loonaarc/conf/docs/evidence.md

# Project Evidence

Paste screenshots and photos directly below each heading.

Tip: after pasting an image, keep the short caption below it. The captions can be reused in the final report.

## 1. Monitoring Node Wiring

Monitoring node current wiring

Figure 1 shows the earlier ESP #1 monitoring-node wiring with PIR, reed switch, DS18B20 temperature sensor, and shared 3.3V/GND breadboard rails. The final architecture moves DS18B20 temperature to the ESP #3 context node; capture updated wiring evidence after the move.

## 2. Monitoring Node Tasmota Module Configuration

Monitoring node current Tasmota module configuration
Figure 2 shows the Tasmota GPIO configuration for ESP #1:

```text
D2 / GPIO4  -> Switch1, PIR motion sensor
D4 / GPIO2  -> DS18x20 temperature sensor in the earlier setup
D6 / GPIO12 -> Switch2, reed switch
```

## 3. Tasmota Console: PIR And Reed Events

Tasmota console with PIR and reed events

Figure 3 shows the Tasmota console publishing `Switch1` events from the PIR sensor and `Switch2` events from the reed switch.

## 4. MQTT Explorer: Switch Events

MQTT Explorer switch result topic

Figure 4 shows MQTT Explorer receiving switch events from the monitoring node under:

```text
stat/safety_monitor_1/RESULT
```

This proves that the sensor node publishes PIR and reed events to the MQTT broker.

## 5. MQTT Explorer: Temperature Sensor

MQTT Explorer temperature sensor telemetry

Figure 5 shows MQTT Explorer receiving DS18B20 temperature telemetry in the earlier setup under:

```text
tele/safety_monitor_1/SENSOR
```

This proves that the monitoring node also publishes periodic sensor telemetry.

## 6. Alarm Node Wiring

Alarm node wiring

Figure 6 shows ESP #2, the alarm node, connected to the relay and PWM buzzer actuator.

## 7. Alarm Node Tasmota Module Configuration

Alarm node Tasmota module configuration

Figure 7 shows the Tasmota GPIO configuration for ESP #2:

```text
D1 / GPIO5  -> Relay1
D5 / GPIO14 -> PWM1 buzzer
D2 / GPIO4  -> Switch1, touch acknowledgement
Topic       -> safety_alarm_1
```

## 8. Safety Context Node Wiring

Safety context node wiring

Figure 8 shows ESP #3, the safety context node, connected to the vibration sensor, microphone module, and DS18B20 temperature sensor.

## 9. Safety Context Node Tasmota Module Configuration

Safety context node current Tasmota module configuration
Figure 9 shows the Tasmota GPIO configuration for ESP #3:

```text
D1 / GPIO5 -> Switch1, vibration sensor
D5 / GPIO14 -> DS18x20 temperature sensor
A0 / GPIO17 -> ADC Input / Analog, microphone AO
Topic      -> safety_context_1
```

## 10. MQTT Explorer: Context Sensor Events And Telemetry

Safety context node telemetry

Figure 10 shows MQTT Explorer receiving context-node sensor events and analog microphone telemetry under:

```text
stat/safety_context_1/RESULT
tele/safety_context_1/SENSOR
```

Current observation:

```text
tele/safety_context_1/SENSOR includes ANALOG.A0 and DS18B20 temperature
SetOption114 1 detached the context-node switches from generic POWER behavior
SwitchMode1 1 was applied
vibration sensor now publishes clean Switch1 ON/OFF action messages
microphone is available as analog A0 telemetry
DS18B20 temperature is available as context-node telemetry
```

This proves the context node is online, the vibration input publishes clean MQTT switch events, and the microphone and temperature values are visible in telemetry.

## 11. openHAB Basic UI: Current Safety-Monitoring View

openHAB Basic UI current safety monitoring view

Figure 11 shows the current openHAB Basic UI with all three distributed nodes integrated:

```text
ESP #1 -> motion, door/reed
ESP #2 -> relay, buzzer power, buzzer intensity
ESP #3 -> vibration, sound level, temperature
```

## 11b. openHAB Basic UI: Temperature Moved To Context Node

Add screenshot after rewiring:

```text
docs/evidence/11b-openhab-basic-ui-temperature-context-node.png
```

Expected screenshot content:

```text
Monitoring Node
  Motion
  Door/Reed

Context Node
  Vibration
  Sound level
  Temperature

Alarm Node
  Touch acknowledgement
```

Figure 11b should show the final per-node UI after moving the DS18B20 temperature sensor to the context node and the touch acknowledgement input to the alarm node.

## 11c. MQTT Explorer: Context Node Temperature Telemetry

Add screenshot after rewiring:

```text
docs/evidence/11c-mqtt-explorer-context-temperature.png
```

Expected MQTT topic:

```text
tele/safety_context_1/SENSOR
```

Expected payload content:

```text
DS18B20.Temperature
```

Figure 11c should prove that the context node now publishes temperature together with its other context telemetry.

## 12. Combined Sensor Events Trigger The Alarm Node

openHAB events log distributed automation proof

Figure 12 shows the distributed automation in `events.log`:

```text
1. Alarm automation is switched ON in the openHAB UI.
2. Vibration from ESP #3 is received by openHAB.
3. Door/reed and motion from ESP #1 are received by openHAB.
4. openHAB rule sends ON commands to the relay and buzzer on ESP #2.
5. BuzzerCommand sends the configured buzzer intensity value.
6. Touch from ESP #2 is received as acknowledgement.
7. openHAB rule sends OFF commands to the relay and buzzer on ESP #2.
8. Alarm automation is switched OFF again.
```

This proves the complete path from distributed sensor events through openHAB rule logic to actuator commands on the alarm node.

## 13. MQTT Explorer: Runtime Topics For All Nodes

MQTT Explorer runtime topics for all safety monitor nodes

Figure 13 shows live MQTT topics for all three distributed nodes:

```text
stat/safety_monitor_1/RESULT  -> monitoring-node sensor events
stat/safety_context_1/RESULT  -> context-node vibration events
stat/safety_alarm_1/RESULT    -> alarm-node touch acknowledgement events
stat/safety_alarm_1/POWER1    -> alarm-node relay state
stat/safety_alarm_1/POWER2    -> alarm-node buzzer state
cmnd/safety_alarm_1/POWER     -> relay command sent through MQTT
cmnd/safety_alarm_1/POWER2    -> buzzer command sent through MQTT
cmnd/safety_alarm_1/Dimmer    -> buzzer intensity command sent through MQTT
```

This proves that Mosquitto is the communication layer between the distributed Tasmota nodes and openHAB. The monitoring and context nodes publish events, while the alarm node receives actuator commands.

## 14. HTTP Binding: External Safety Context

openHAB GeoSphere Austria external safety context

Figure 14 shows openHAB reading official GeoSphere Austria warning data through the HTTP binding.

The current warning area is:

```text
Wien-Innere Stadt
```

The active warning count is currently `0`, so there is no warning level or warning text shown. This is the expected state when GeoSphere Austria has no active warning for the selected coordinates.

This proves that the project uses both communication paths required for the safety-monitoring system:

```text
MQTT -> local distributed IoT nodes
HTTP -> external official safety context
```

## 15. Network Plan

Network plan for distributed safety monitoring

The network plan is documented as PlantUML in:

```text
docs/network-plan.puml
```

It shows:

```text
ESP #1 Safety Monitor  -> Wi-Fi -> Mosquitto -> openHAB
ESP #3 Safety Context  -> Wi-Fi -> Mosquitto -> openHAB
openHAB rules          -> Mosquitto -> ESP #2 Safety Alarm
GeoSphere Austria API  -> HTTP binding -> openHAB
MQTT Explorer          -> Mosquitto for debugging/evidence
Browser                -> openHAB Basic UI and Tasmota web UIs
```

## 16. openHAB Basic UI: Node Availability Online

openHAB node availability online

Figure 16 should show that openHAB receives and displays MQTT Last Will and Testament values for all distributed Tasmota nodes.

## 17. openHAB Basic UI: Node Availability Offline Test

openHAB node availability offline test

Figure 17 should show that the MQTT broker publishes the LWT `Offline` state when a node disappears and openHAB displays the changed availability state.

## 18. openHAB Basic UI: Risk Score And Alarm State

openHAB risk score summary

Figure 18 shows that openHAB calculates and displays a local risk score from distributed sensor context.

## 19. events.log: Risk Level Triggers Alarm

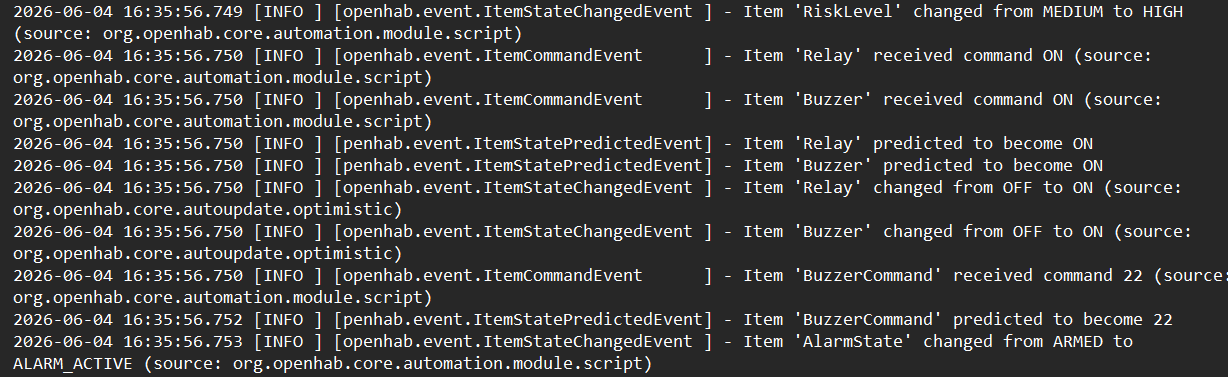
[picture p12: docs/evidence/19-events-log-risk-level-triggers-alarm.png]
events log risk level triggers alarm


Figure 19 proves that the alarm is now triggered by calculated risk state, not only by one hard-coded sensor pair.

The log shows `RiskLevel` changing to `HIGH`, openHAB sending `ON` commands to `Relay` and `Buzzer`, and `AlarmState` changing to `ALARM_ACTIVE`.

## 20. events.log: Touch Acknowledges Alarm

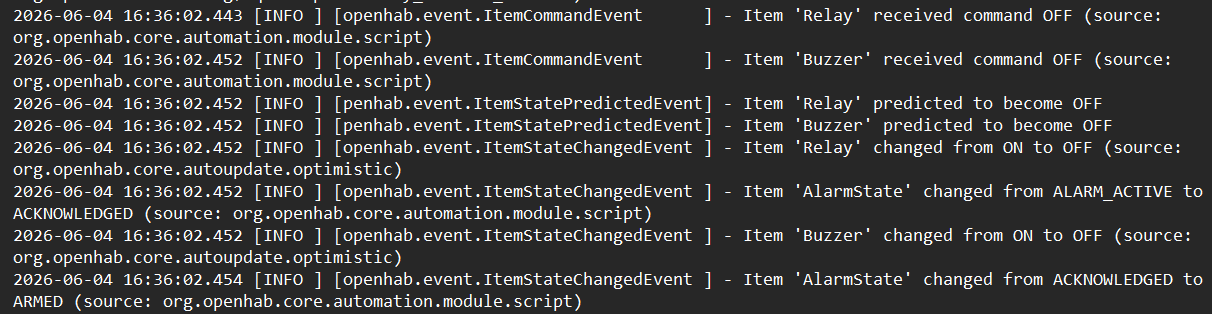
[picture p13: docs/evidence/20-events-log-touch-acknowledges-alarm.png]
events log touch acknowledges alarm


Figure 20 shows the touch acknowledgement flow. openHAB sends `OFF` commands to `Relay` and `Buzzer`, `AlarmState` changes to `ACKNOWLEDGED`, and then returns to `ARMED` after the risk/alarm-state rule recalculates.

## 21. openHAB Basic UI: JDBC History Charts

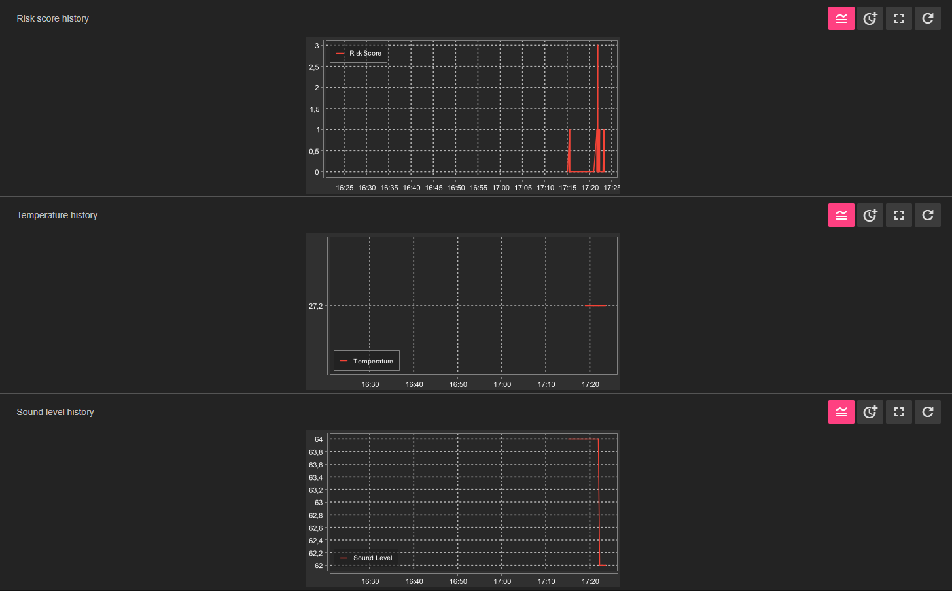
[picture p14: docs/evidence/21-openhab-history-charts-jdbc.png]
openHAB JDBC history charts


Figure 21 shows that persisted historical values are displayed in the openHAB Sitemap UI.

## 22. JDBC SQLite Persistence Proof

JDBC SQLite persistence proof

Figure 22 proves that a non-default JDBC/SQLite persistence backend is configured instead of relying only on default `rrd4j`.

## 23. Mosquitto Local Broker Security Configuration

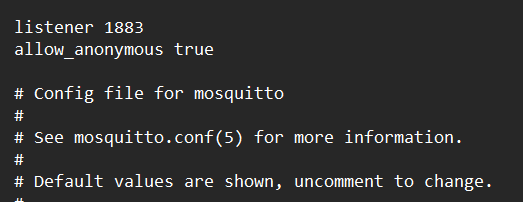
[picture p15: docs/evidence/23-mosquitto-local-broker-config.png]
Mosquitto local broker security configuration


Figure 23 should document the current local lab MQTT broker setup and its security limitation.

## 24. Tasmota MQTT Configuration

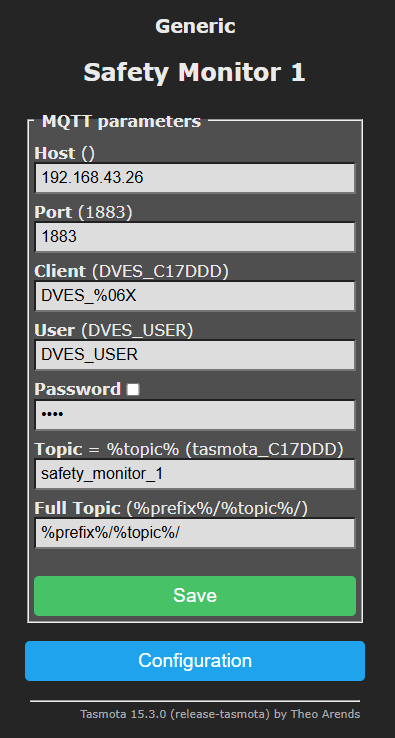
[picture p16: docs/evidence/24-tasmota-mqtt-config-safety-monitor.png]
Tasmota MQTT configuration safety monitor


Figure 24 shows the Tasmota MQTT configuration for the safety monitor node, including local broker host, port `1883`, and topic `safety_monitor_1`. Password information should not be shared beyond this local project evidence.

## 25. openHAB Local UI Access

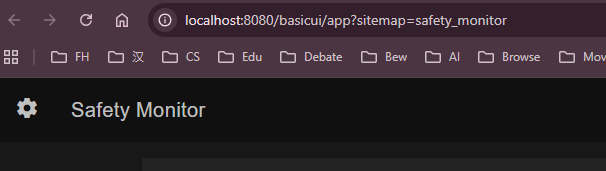
[picture p17: docs/evidence/25-openhab-local-ui-access.png]
openHAB local UI access


Figure 25 should show that the current openHAB UI is used as a local lab interface, not a directly public internet endpoint.

## 26. myopenHAB Remote Access Online

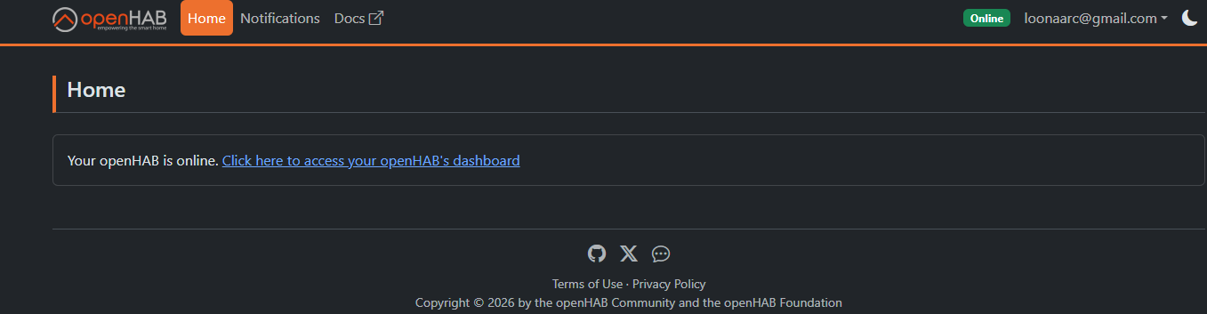
[picture p18: docs/evidence/26-myopenhab-remote-access-online.png]
myopenHAB remote access online


Figure 26 should prove internet access to the openHAB UI through myopenHAB Cloud Connector instead of direct public port forwarding.

## 27. myopenHAB Remote Basic UI Sitemap

myopenHAB remote Basic UI sitemap

Figure 27 shows the project sitemap route opened remotely through myopenHAB:

```text
https://myopenhab.org/basicui/app?sitemap=safety_monitor
```

This is the relevant remote UI for the project because the implementation uses a file-based Basic UI sitemap rather than MainUI pages.

## 28. ESP32 INMP441 I2S Microphone Test

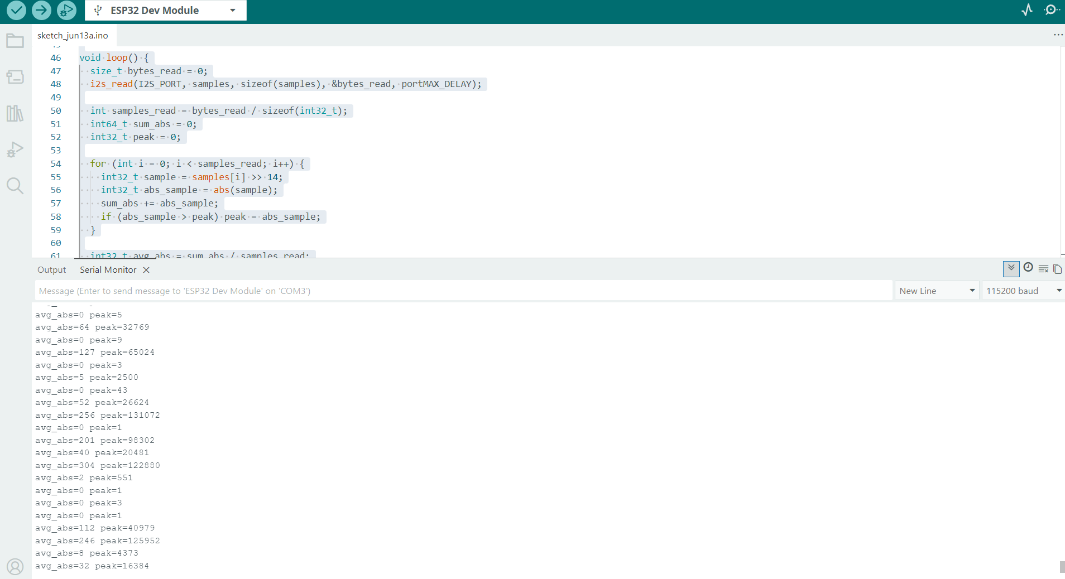
[picture p19: docs/evidence/28-esp32-inmp441-i2s-serial-test.png]
ESP32 INMP441 I2S serial test


Verified wiring:

```text
INMP441 VDD -> ESP32 3V3
INMP441 GND -> ESP32 GND
INMP441 L/R -> ESP32 GND
INMP441 SCK -> ESP32 D14 / GPIO14
INMP441 WS  -> ESP32 D15 / GPIO15
INMP441 SD  -> ESP32 D32 / GPIO32
```

Figure 28 proves that the ESP32 can be flashed, the USB serial connection works, and the INMP441 microphone produces I2S audio data that reaches the ESP32.

## 29. ESP32 Audio Feature Serial Test

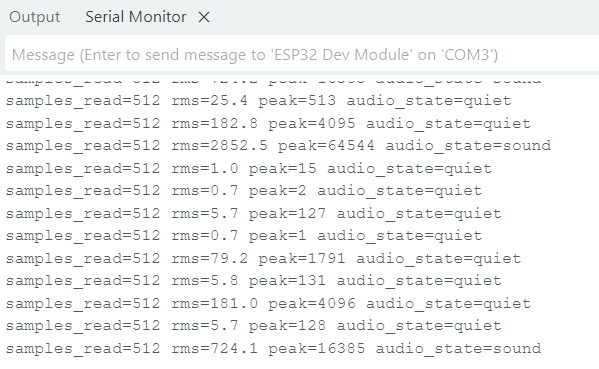
[picture p20: docs/evidence/29-esp32-audio-features-serial-test.png]
ESP32 audio feature serial test


Figure 29 shows the second ESP32 audio debug sketch. It computes a small feature summary from each I2S audio buffer:

```text
samples_read=512
rms=...
peak=...
audio_state=quiet/sound
```

This proves that the ESP32 can already reduce raw microphone samples into summarized audio features. That is the same design principle planned for the final TinyML node: openHAB should receive compact summaries, not raw audio.

## 30. ESP32 MQTT Audio Feature Publishing

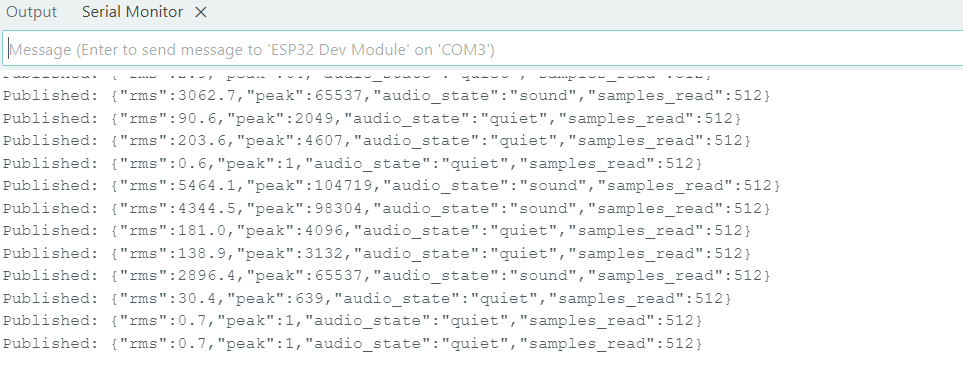
[picture p21: docs/evidence/30-esp32-mqtt-features-serial.png]
ESP32 MQTT audio feature publishing


Figure 30 shows the Arduino IDE Serial Monitor output from sketch `04_mqtt_features`. The ESP32 captures I2S audio, computes RMS and peak values, and publishes a JSON payload to the MQTT broker once per second:

```text
tele/safety_audio_1/FEATURES
```

Example payloads:

```json
{"rms":3062.7,"peak":65537,"audio_state":"sound","samples_read":512}
{"rms":90.6,"peak":2049,"audio_state":"quiet","samples_read":512}
{"rms":5464.1,"peak":104719,"audio_state":"sound","samples_read":512}
```

This proves that the ESP32 audio node connects to Wi-Fi, establishes an MQTT connection to the Mosquitto broker, and publishes structured audio feature data. The `audio_state` field switches correctly between `quiet` and `sound` in response to real microphone input. This is the debug feature topic used during development. The final deployment topic will be `tele/safety_audio_1/CLASSIFICATION` once the TinyML model is deployed on the ESP32.

## 31. openHAB Basic UI: Geolocation Map

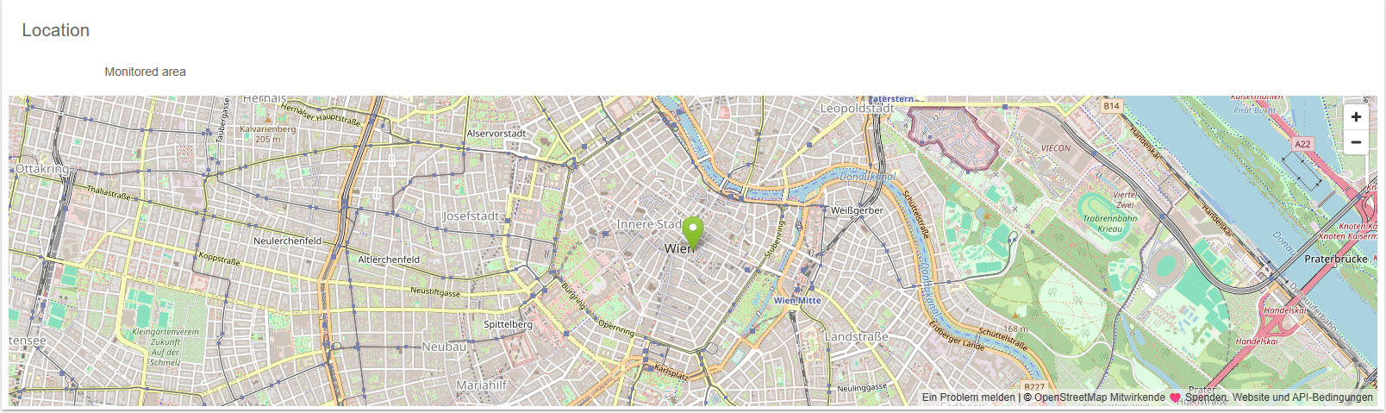
[picture p22: docs/evidence/31-openhab-geolocation-map.png]
openHAB Basic UI geolocation map


Figure 31 shows the geolocation map widget in the openHAB Basic UI. A `Location` item (`MonitoredArea`) is initialized on system startup with the coordinates of the monitored site in Vienna (`48.2082, 16.3738`). The map pin confirms that the monitored area is registered and visible in the UI. This satisfies the geolocation-based map requirement.

## 32. openHAB MainUI: Safety Dashboard Page

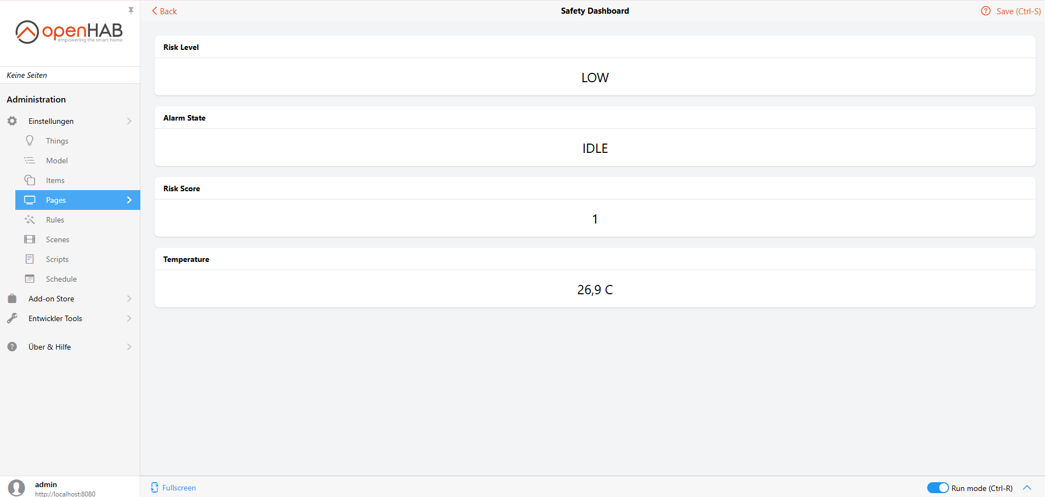
[picture p23: docs/evidence/32-openhab-mainui-safety-dashboard.png]
openHAB MainUI Safety Dashboard


Figure 32 shows the custom Safety Dashboard page created in the openHAB MainUI. It displays live values from four Items: RiskLevel (LOW), AlarmState (IDLE), RiskScore (1), and Temperature (26.9°C). The dashboard is separate from the file-based Basic UI sitemap and satisfies the additional MainUI page requirement.

## 33. ESP32 Audio Node: INMP441 Wiring Photo

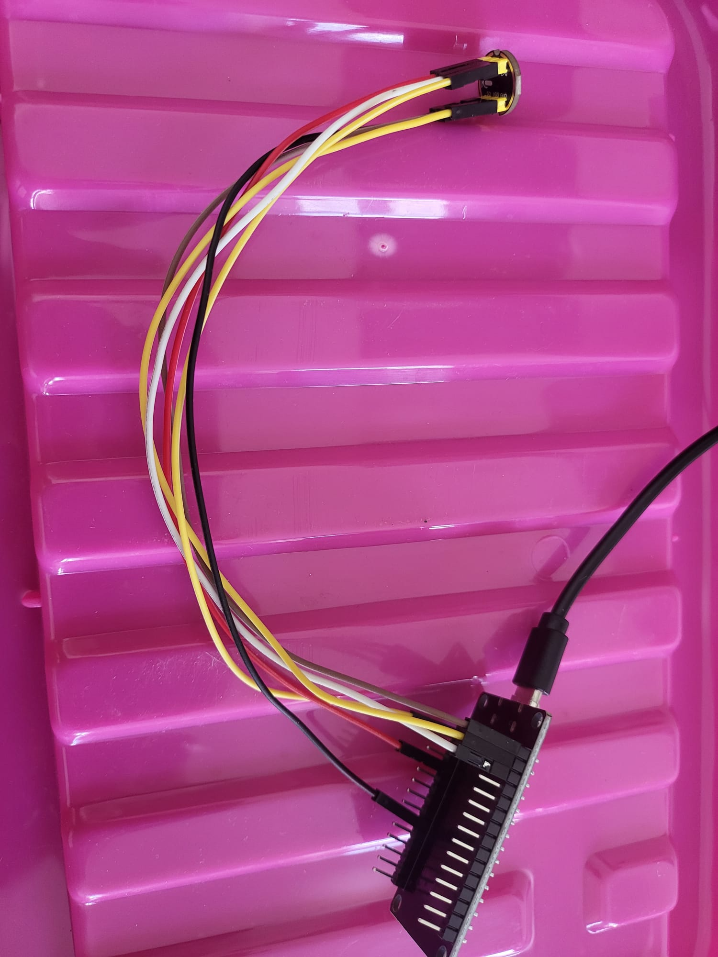
[picture p24: docs/evidence/33-esp32-inmp441-wiring.png]
ESP32 INMP441 wiring


Figure 33 shows the ESP32 Dev Module connected to the INMP441 I2S microphone on a breadboard. The verified wiring is:

```text
INMP441 VDD -> ESP32 3V3
INMP441 GND -> ESP32 GND
INMP441 L/R -> ESP32 GND
INMP441 SCK -> ESP32 D14 / GPIO14
INMP441 WS  -> ESP32 D15 / GPIO15
INMP441 SD  -> ESP32 D32 / GPIO32
```

This is the hardware base for the TinyML audio node running sketch `04_mqtt_features` and the planned `05_tinyml_inference`.

## 34. EasyEDA Wiring Plan: All Three D1 Mini Nodes

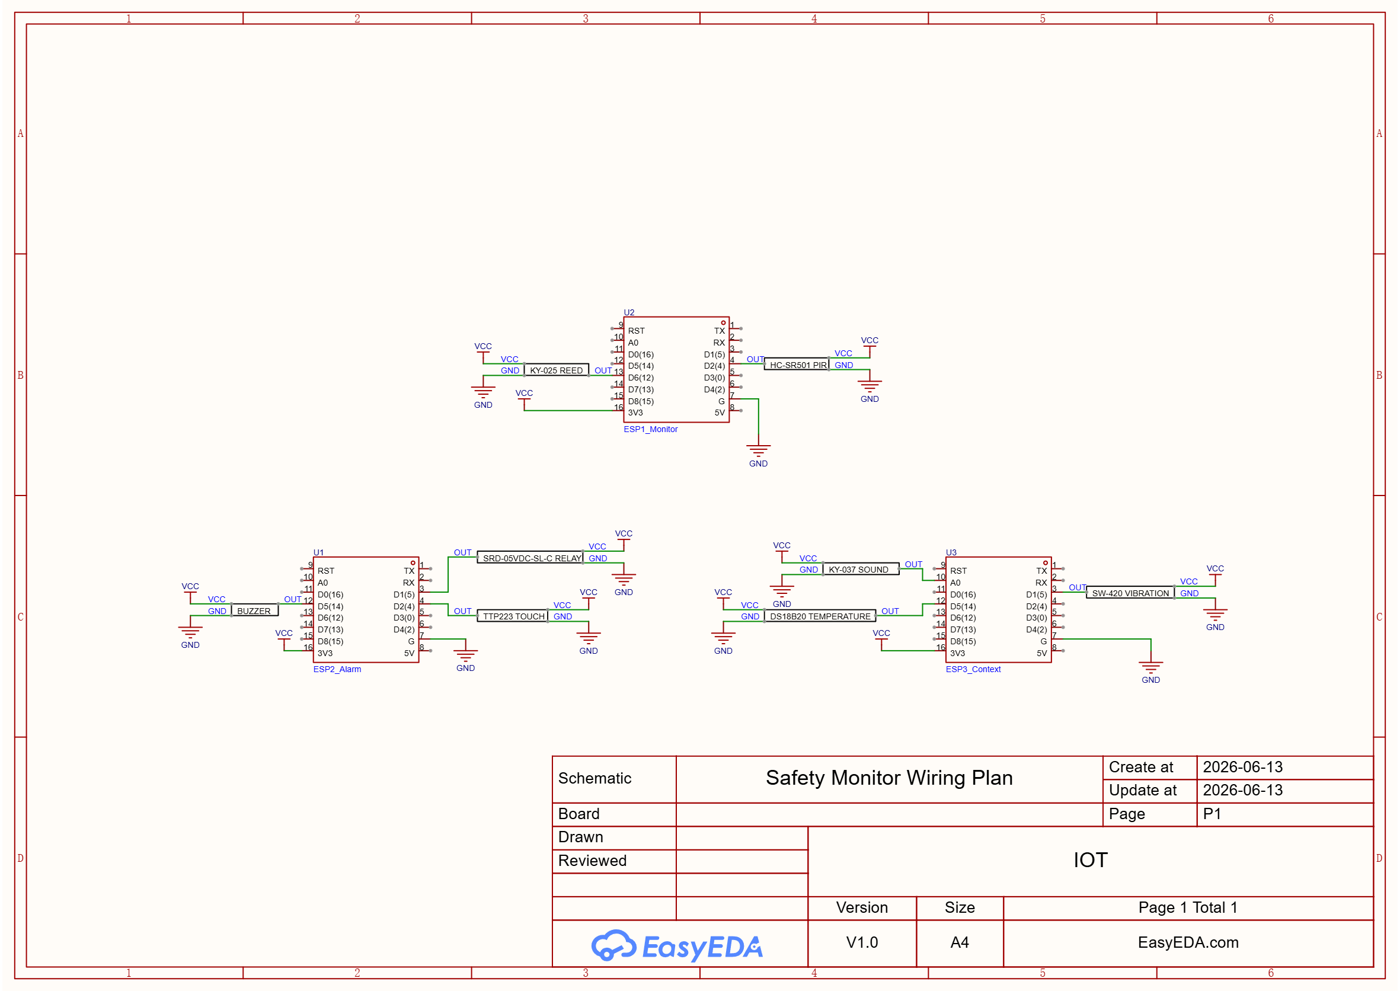
[picture p25: docs/evidence/34-easyeda-wiring-plan.png]
EasyEDA wiring plan for all three D1 Mini nodes


Figure 34 shows the schematic wiring plan for all three Tasmota D1 Mini nodes drawn in EasyEDA. Each node is represented as a Wemos D1 Mini symbol with its connected sensor or actuator modules:

ESP1 Monitor:
- HC-SR501 PIR motion sensor → D2 / GPIO4 (Switch1)
- KY-025 Reed switch → D6 / GPIO12 (Switch2)

ESP2 Alarm:
- Buzzer → D5 / GPIO14 (PWM1)
- SRD-05VDC relay → D1 / GPIO5 (Relay1)
- TTP223 touch sensor → D2 / GPIO4 (Switch1)

ESP3 Context:
- KY-037 sound sensor → A0 / GPIO17 (ADC analog input)
- DS18B20 temperature sensor → D5 / GPIO14 (DS18x20)
- SW-420 vibration sensor → D1 / GPIO5 (Switch1)

Each sensor module is shown with its VCC, GND, and signal connections. VCC and GND power symbols are shared across the schematic as global nets.

## 35. EasyEDA Wiring Plan: Including ESP32 Audio Node

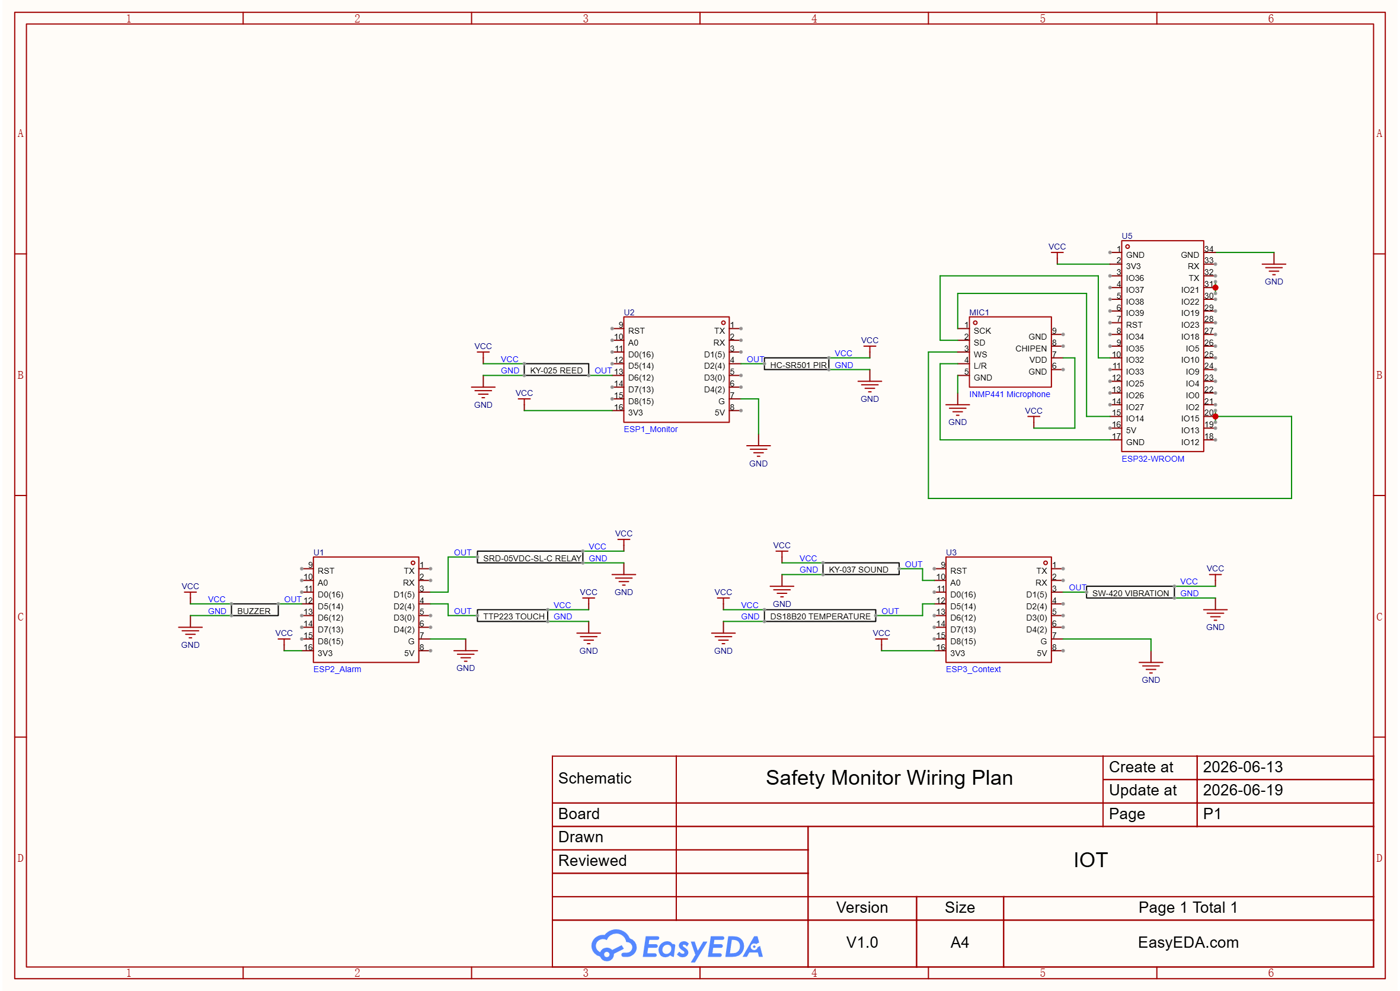
[picture p26: docs/evidence/35-easyeda-wiring-plan-esp32.png]
EasyEDA wiring plan including ESP32 audio node


Figure 35 is an updated schematic wiring plan drawn in EasyEDA. It extends the three Tasmota D1 Mini nodes from figure 34 with the ESP32 audio node:

ESP32 Audio Node:
- INMP441 I2S microphone VDD → 3V3
- INMP441 SCK → D14 / GPIO14
- INMP441 WS → D15 / GPIO15
- INMP441 SD → D32 / GPIO32
- INMP441 L/R → GND (left channel select)

## Evidence Chain

The final proof chain for the recorded demo is:

```text
1. openHAB automation is enabled from the Basic UI
2. Node availability is shown through MQTT LWT status Items
3. Vibration event is published by ESP #3 / Safety Context 1
4. Door/reed and PIR motion events are published by ESP #1 / Safety Monitor 1
5. Mosquitto forwards the MQTT events to openHAB
6. openHAB recalculates RiskScore and RiskLevel from distributed sensor evidence
7. RiskLevel HIGH or CRITICAL triggers MQTT commands to ESP #2 / Safety Alarm 1
8. ESP #2 switches the relay and buzzer actuator
9. Touch event from ESP #2 acknowledges the alarm
10. openHAB sends MQTT OFF commands to ESP #2
11. JDBC/SQLite persistence stores selected Item history
12. Basic UI history charts display RiskScore, Temperature, and SoundLevel
13. myopenHAB provides remote access without direct public port forwarding
14. Optional ESP32 TinyML audio-node hardware test proves local I2S microphone capture
15. Optional ESP32 audio feature sketch proves local feature extraction before MQTT/TinyML integration
16. Optional ESP32 MQTT audio feature publishing proves the full ESP32 -> Wi-Fi -> MQTT -> broker pipeline for the audio node
17. openHAB automation is disabled from the Basic UI
```

The external safety-context proof chain is:

```text
GeoSphere Austria Warn API
  -> openHAB HTTP binding
  -> GeoSphere warning Items
  -> Basic UI External Safety Context frame
```
