loonaarc/conf/docs/03-wiring.md

# Wiring Guide

## Schematic Wiring Plan

A schematic wiring plan for all three D1 Mini nodes was drawn in EasyEDA and is captured in evidence 34:

```text
docs/evidence/34-easyeda-wiring-plan.png
```

The schematic shows each node as a Wemos D1 Mini symbol with its connected sensor and actuator modules, including VCC, GND, and signal connections for each component.

An updated plan including the ESP32 audio node with INMP441 I2S microphone is captured in evidence 35:

EasyEDA wiring plan including ESP32 audio node

## Node Overview

This guide documents the current hardware setup:

```text
ESP #1 Safety Monitor  -> PIR + reed
ESP #2 Safety Alarm    -> relay + PWM buzzer + touch acknowledgement
ESP #3 Safety Context  -> vibration + microphone + temperature
```

## Breadboard Basics

A breadboard lets you connect components without soldering.

The long side rails are usually used for power:

```text
red rail  -> 3.3V in this project
blue rail -> GND
```

For this project, use the D1 Mini `3V3` pin for the breadboard power rail unless a specific module explicitly requires 5V. This keeps the sensor outputs safer for the ESP8266 GPIO pins, which are 3.3V logic pins.

On most breadboards, each long red rail is connected along its length, and each long blue rail is connected along its length. Some breadboards split the long rails in the middle, so check the printed line on the breadboard or test continuity if a sensor does not power on.

Use the rails to share the one D1 Mini power pin with several sensors:

```text
D1 Mini 3V3       -> red rail
D1 Mini GND       -> blue rail
sensor VCC/+      -> red rail
sensor GND/-      -> blue rail
```

The middle area is split into rows. On a typical breadboard, five holes in the same row are connected:

```text
a b c d e     connected together
f g h i j     connected together
```

The gap in the middle separates the two sides. A component placed across the middle gap has its pins separated, which is useful for modules and chips.

Important rule:

```text
GND must be shared.
```

If a sensor and the D1 Mini use different power sources, their GND pins still need to be connected together for the signal to make sense.

## D1 Mini Pin Names

The D1 Mini labels pins as `D1`, `D2`, etc. Internally, the ESP8266 uses GPIO numbers.

| D1 Mini label | ESP8266 GPIO | Suggested use |
| --- | --- | --- |
| `D1` | GPIO5 | Relay, already used in Lab 1 |
| `D2` | GPIO4 | PIR motion input on ESP #1 / touch acknowledgement input on ESP #2 |
| `D4` | GPIO2 | Previously used for DS18x20 on ESP #1; now unused |
| `D6` | GPIO12 | Reed switch input |
| `D5` | GPIO14 | PWM buzzer on ESP #2 / DS18x20 temperature sensor on ESP #3 |
| `D7` | GPIO13 | Extra digital input |

Avoid using `D3`, `D4`, and `D8` for beginner sensor wiring unless needed, because they can affect boot behavior if pulled to the wrong state.

The current working monitoring-node setup is:

```text
D2 / GPIO4 -> PIR motion sensor as Switch1
D6 / GPIO12 -> Reed switch as Switch2
```

Recommended Tasmota module settings for this setup:

```text
GPIO4  (D2) -> Switch1
GPIO12 (D6) -> Switch2
```

## DS18B20 Temperature Sensor

For the DS18B20 temperature sensor, hold the sensor with the flat side facing you and the legs pointing downward:

```text
Left   -> GND
Middle -> DATA
Right  -> VCC 3.3V
```

Current wiring:

| DS18B20 pin | D1 Mini / breadboard |
| --- | --- |
| `GND` | blue rail / `GND` |
| `DATA` | ESP #3 `D5` / GPIO14 |
| `VCC` | red rail / `3V3` |

Tasmota publishes the temperature periodically under:

```text
tele/safety_context_1/SENSOR
```

Example payload:

```json
{"DS18B20":{"Temperature":23.8},"TempUnit":"C"}
```

## PIR Sensor HC-SR501

Typical pins:

```text
VCC
OUT
GND
```

Recommended wiring for ESP #1 monitoring node:

| PIR pin | D1 Mini |
| --- | --- |
| `VCC` | red rail / `3V3` |
| `OUT` | `D2` / GPIO4 in the current lab setup |
| `GND` | `GND` |

Some HC-SR501 PIR modules are often powered with 5V, but for this project start with 3.3V if the module works reliably. If a module must use 5V, check that its `OUT` pin is still 3.3V-safe before connecting it to the ESP8266.

Recommended Tasmota module setting:

```text
GPIO4 (D2) -> Switch1
```

The current openHAB config already expects a Switch1-style JSON field:

```text
$.Switch1.Action
```

## Reed Switch / Magnetic Sensor

A reed switch is a simple magnetic contact. It behaves like a button:

```text
magnet near     -> contact closed or open, depending on module
magnet away     -> opposite state
```

For a bare two-wire reed switch, use:

| Reed wire | D1 Mini |
| --- | --- |
| one side | `D6` / GPIO12 |
| other side | `GND` |

A bare reed switch does not need VCC. It is only a magnetic contact, like a button.

If the reed sensor is a small module with pins marked `+`, `G`, `DO`, and sometimes `AO`, wire it like this:

| Reed module pin | D1 Mini / breadboard |
| --- | --- |
| `+` or `VCC` | red rail / `3V3` |
| `G` or `GND` | blue rail / `GND` |
| `DO` | `D6` / GPIO12 |
| `AO` | not used |

Use `DO`, not `AO`, for Tasmota switch input. `DO` is the digital on/off output. `AO` is an analog output and is not needed for a door/window open/closed state.

Use a pull-up input mode in Tasmota if available, for example:

```text
GPIO12 (D6) -> Switch2
```

The reed module has been verified with a magnet. At first, Tasmota reported `Switch2` as `TOGGLE`, which proved that the input was working but was not clean enough for the openHAB `Door/Reed` switch item. The following Tasmota console command was necessary so the reed switch reports explicit `ON` and `OFF` states:

```text
SwitchMode2 1
```

If the displayed door/reed state is backwards, use inverted follow mode instead:

```text
SwitchMode2 2
```

Depending on how the reed switch behaves, the state may be inverted. That is normal and can be adjusted later in Tasmota or openHAB.

If Tasmota telemetry shows `"Switch2":"OFF"` but no `Switch2` change appears in the console:

1. Confirm Tasmota has `GPIO12 (D6) -> Switch2`.
2. Confirm the reed module `DO` pin goes to `D6`, not `AO`.
3. Confirm the module `GND` is connected to the same GND rail as the D1 Mini.
4. Try both magnet positions and both sides of the reed sensor, because the active area can be small.
5. Watch for the module LED, if it has one. It should usually change when the magnet moves.
6. Briefly test the D6 input directly by connecting `D6` to `GND`. If Tasmota logs `Switch2`, the D1/Tasmota side works and the issue is the reed module or magnet position.

## Alarm Node

The alarm node is separate from the monitoring node.

The relay has been moved to ESP #2 so that a sensor event on ESP #1 can later trigger an actuator on ESP #2.

Recommended first version:

| Component | D1 Mini pin |
| --- | --- |
| Relay module signal | `D1` / GPIO5 |
| Buzzer signal | `D5` / GPIO14 |
| Touch sensor signal | `D2` / GPIO4 |
| GND | `GND` |

Current ESP #2 Tasmota setting:

```text
GPIO5 (D1) -> Relay1
GPIO14 (D5) -> PWM1
GPIO4 (D2) -> Switch1, touch acknowledgement
Topic -> safety_alarm_1
```

Recommended touch-sensor wiring for ESP #2:

| Touch sensor pin | D1 Mini / breadboard |
| --- | --- |
| `VCC` | red rail / `3V3` |
| `GND` | blue rail / `GND` |
| `SIG` | ESP #2 `D2` / GPIO4 |

Run these Tasmota console commands on ESP #2 so the touch input behaves like a sensor input and does not directly toggle the relay:

```text
SetOption114 1
SwitchMode1 1
```

Be careful with current:

- The ESP8266 GPIO pins are signal pins, not power outputs.
- A relay module usually needs external 5V power.
- If a separate 5V supply is used for a relay module, the D1 Mini and relay/buzzer power supply must share GND.
- Do not power high-current loads directly from a GPIO pin.

If the relay used to click when it was plugged directly on top of the D1 Mini but does not click when wired on the breadboard, check that the relay has all required connections, not only the signal pin:

```text
relay signal/input -> D1 / GPIO5
relay VCC/+        -> required relay supply
relay GND/-        -> D1 Mini GND / shared ground rail
```

A mechanical relay clicks only when its coil is powered and switched. If only the signal wire is connected, Tasmota can publish `POWER ON/OFF` but the relay hardware will not move.

The buzzer first only made a quiet click when configured as a relay-style output. It worked after changing the Tasmota module setting to PWM:

```text
GPIO14 (D5) -> PWM1
```

Working Tasmota console commands:

```text
Dimmer 50
POWER2 OFF
```

Tasmota reported:

```text
stat/safety_alarm_1/RESULT = {"POWER2":"ON","Dimmer":50}
stat/safety_alarm_1/RESULT = {"POWER2":"OFF"}
stat/safety_alarm_1/POWER2 = OFF
```

For openHAB, the useful MQTT command topics are:

```text
cmnd/safety_alarm_1/Dimmer
cmnd/safety_alarm_1/POWER2
```

Use `Dimmer 50` or MQTT payload `50` on `cmnd/safety_alarm_1/Dimmer` to sound the buzzer, and `OFF` on `cmnd/safety_alarm_1/POWER2` to stop it.

## Safety Context Node

ESP #3 is the safety context node. It adds secondary event sources so the final rule can become more interesting than a single sensor trigger.

Current ESP #3 role:

```text
Topic -> safety_context_1
Purpose -> vibration, loud-sound, and temperature context
```

Recommended wiring:

| Component | Module pin | D1 Mini / breadboard |
| --- | --- | --- |
| Vibration sensor | `VCC` / `+` | red rail / `3V3` |
| Vibration sensor | `GND` / `G` | blue rail / `GND` |
| Vibration sensor | `DO` | `D1` / GPIO5 |
| Microphone sensor | `VCC` / `+` | red rail / `3V3` |
| Microphone sensor | `GND` / `G` | blue rail / `GND` |
| Microphone sensor | `AO` | `A0` / GPIO17 |
| Microphone sensor | `DO` | not used |
| DS18B20 | `GND` | blue rail / `GND` |
| DS18B20 | `DATA` | `D5` / GPIO14 |
| DS18B20 | `VCC` | red rail / `3V3` |

The microphone uses the analog `AO` output because it is more useful for later TinyML-style sound-level experiments than a simple threshold switch.

Recommended ESP #3 Tasmota module settings:

```text
Module type -> Generic
GPIO5 (D1) -> Switch1   vibration
GPIO14 (D5) -> DS18x20  temperature
GPIO17 (A0) -> ADC Input / Analog, microphone AO
Topic      -> safety_context_1
```

Expected MQTT topics:

```text
stat/safety_context_1/RESULT
tele/safety_context_1/SENSOR
```

Example payloads:

```json
{"Switch1":{"Action":"ON"}}
{"ANALOG":{"A0":61}}
{"DS18B20":{"Temperature":23.8},"TempUnit":"C"}
```

The verified ESP #3 context-node command set is:

```text
SetOption114 1
SwitchMode1 1
```

`SetOption114 1` detaches the switch inputs from Tasmota's default power-output behavior. This is important for ESP #3 because it is a sensor-only context node, not an actuator node.

If the vibration sensor publishes generic `POWER` messages instead of `Switch1` action messages, run the verified command set again:

```text
SetOption114 1
SwitchMode1 1
```

Then test again. The desired result is:

```text
stat/safety_context_1/RESULT = {"Switch1":{"Action":"ON"}}
stat/safety_context_1/RESULT = {"Switch1":{"Action":"OFF"}}
```

The generic `POWER` topic is normal Tasmota wording, but it is confusing in this project because only ESP #2 is supposed to be an actuator node. For ESP #3, prefer `Switch1` messages plus `ANALOG.A0` and `DS18B20` telemetry.

Use the blue potentiometer on the vibration module to adjust the digital threshold. The microphone is currently analog, so it should be checked by watching whether `ANALOG.A0` changes when the sound level changes.

## ESP32 TinyML Audio Node

The ESP32 audio node is separate from the Tasmota D1 Mini nodes. It uses custom Arduino/PlatformIO firmware because Tasmota is not the right target for running the future TinyML audio model.

Current verified hardware:

```text
Board -> ESP32 Dev Module
Port  -> COM3 during local Arduino IDE test
Mic   -> INMP441 I2S microphone
```

Working INMP441 wiring:

| INMP441 pin | ESP32 board label | GPIO used in code |
| --- | --- | --- |
| `VDD` | `3V3` | power |
| `GND` | `GND` | ground |
| `L/R` | `GND` | left channel select |
| `SCK` | `D14` | GPIO14 |
| `WS` | `D15` | GPIO15 |
| `SD` | `D32` | GPIO32 |

Important notes:

- On this ESP32 board, labels such as `D14`, `D15`, and `D32` correspond to GPIO14, GPIO15, and GPIO32 in Arduino code.
- All ESP32 `GND` pins are connected together, so microphone `GND` and `L/R` can use different physical GND pins.
- `VDD` must use `3V3`, not `VIN`.
- The `SD` line on `D32` is the microphone data line. If it is missing, the sketch can still run but will print only zeros.

Verified Arduino test pins:

```cpp
#define I2S_WS 15
#define I2S_SD 32
#define I2S_SCK 14
```

Verified serial test result:

```text
avg_abs and peak values change when sound is made near the microphone
```

This proves that the ESP32 can be flashed, the serial monitor works, and the INMP441 sends I2S audio data to the ESP32.

## First Wiring Target

Build only the monitoring node first:

```text
D1 Mini
  D2 -> PIR OUT
  D6 -> reed DO, or one side of a bare reed switch
  GND -> blue breadboard rail
  3V3 -> red breadboard rail
```

Then build the context node:

```text
D1 Mini
  D1 -> vibration DO
  D5 -> DS18x20 data
  A0 -> microphone AO
  GND -> blue breadboard rail
  3V3 -> red breadboard rail
```

Then add the touch input to the alarm node:

```text
D1 Mini
  D2 -> touch SIG
  GND -> blue breadboard rail
  3V3 -> red breadboard rail
```

Then verify in this order:

1. Tasmota web page opens.
2. Tasmota console shows sensor events.
3. Open MQTT Explorer and connect it to the broker.
4. MQTT Explorer shows `stat/safety_monitor_1/RESULT` when `Switch1` or `Switch2` changes.
5. MQTT Explorer shows `tele/safety_context_1/SENSOR` for the DS18x20 temperature value.
6. openHAB receives the item state.
7. openHAB rule calculates risk score.

Current verified result:

```text
MQTT connected: yes
PIR on Switch1: yes, publishes stat/safety_monitor_1/RESULT
DS18B20 temperature: yes, publishes tele/safety_context_1/SENSOR after moving it to the context node
Switch2 in telemetry: yes
Reed change event: yes, publishes Switch2 when triggered by magnet
ESP #2 relay on safety_alarm_1: yes, clicks when toggled in Tasmota
ESP #2 buzzer on safety_alarm_1: yes, works with PWM1 and Dimmer 50
ESP #2 touch acknowledgement: wired on D2 / GPIO4 as Switch1
ESP #3 context node on safety_context_1: wired with vibration, microphone, and temperature sensors
ESP #3 context switch behavior: fixed with SetOption114 1 + SwitchMode1 1
ESP #3 microphone: visible as analog telemetry under ANALOG.A0
ESP #3 temperature: visible as DS18B20 telemetry
ESP #3 vibration: visible in telemetry, not yet verified as clean event trigger
ESP32 audio node: INMP441 I2S microphone test verified locally with changing avg_abs/peak serial output
```

Important MQTT Explorer note:

- `stat/safety_monitor_1/RESULT` updates immediately when `Switch1` or `Switch2` changes.
- `tele/safety_context_1/SENSOR` is periodic. With the current `TelePeriod` of 300 seconds, temperature may only update about every 5 minutes unless Tasmota is restarted or telemetry is requested.

The core final-check build only needs the monitoring node and the alarm node to be stable. The context node can be added after that, and the fourth D1 Mini is optional if it cannot be recovered.
