loonaarc/conf/docs/evidence/00-monitor-node-wiring-alternate.png

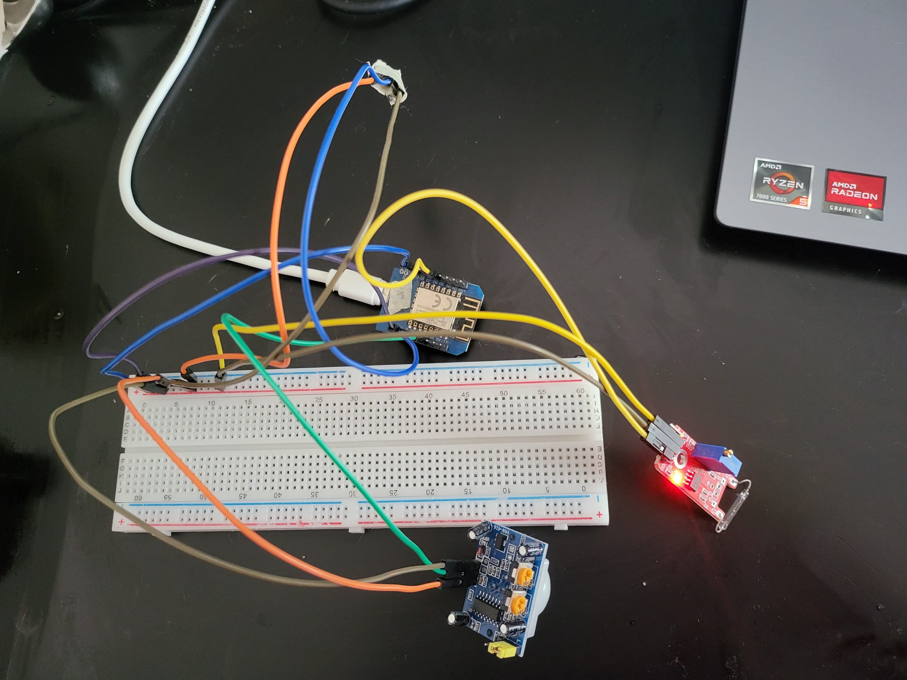
docs/evidence/00-monitor-node-wiring-alternate.png
