loonaarc/conf/docs/evidence/01-monitor-node-wiring.png

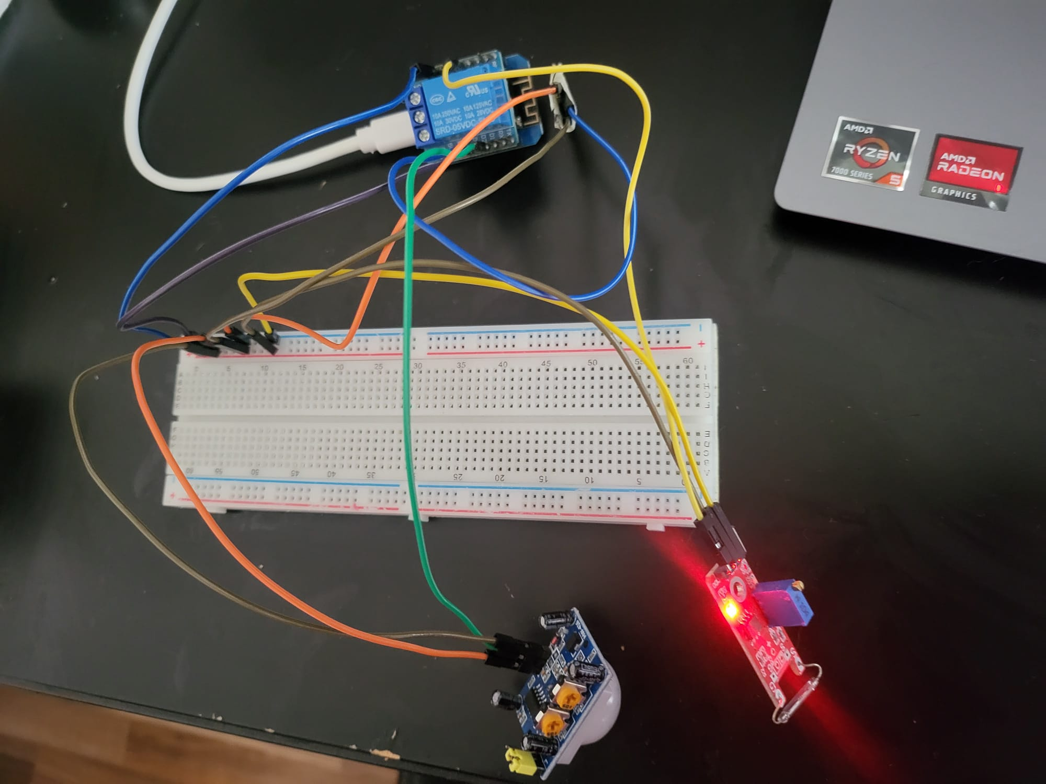
docs/evidence/01-monitor-node-wiring.png
