loonaarc/conf/tinyml/esp32_audio_node/arduino/05_tinyml_inference/05_tinyml_inference.ino

// ESP32 TFLite Micro sound classification with MQTT publishing.
// Model: distilled student v15  –  int8 I/O, SepConv->BN->ReLU, BN folded, arena ~90 KB.
//
// Captures 2 s of audio at 16 kHz, computes a 171x64 log-mel spectrogram,
// runs the distilled int8 model, and publishes the result via MQTT.
//
// Firmware applies: int8 = round((logmel - NORM_MEAN) / NORM_STD / INPUT_SCALE + INPUT_ZERO_POINT)
#define NORM_MEAN        -4.540420f
#define NORM_STD          6.041347f
#define INPUT_SCALE       0.01590111f
#define INPUT_ZERO_POINT  (-31)
//
// NOTE – sample-rate mismatch (known project limitation):
//   Training: 44.1 kHz audio, mel range 80–16000 Hz.
//   ESP32:    16 kHz capture, Nyquist = 8 kHz, mel range 80–8000 Hz.
//   STFT frame/step are time-scaled to keep the same 171×64 output shape.
//   Most safety-relevant sound energy is below 8 kHz; limitation is acceptable.

#include <Arduino.h>
#include <driver/i2s.h>
#include <math.h>
#include <WiFi.h>
#include <PubSubClient.h>
#include <TensorFlowLite_ESP32.h>
#include "tensorflow/lite/micro/all_ops_resolver.h"
#include "tensorflow/lite/micro/micro_error_reporter.h"
#include "tensorflow/lite/micro/micro_interpreter.h"
#include "tensorflow/lite/schema/schema_generated.h"

#include "model_data.h"

// ── Wi-Fi / MQTT ───────────────────────────────────────────────────────────
#define WIFI_SSID     "realme C3"
#define WIFI_PASSWORD "easy098!"
#define MQTT_HOST     "192.168.43.26"
#define MQTT_PORT     1883
#define MQTT_TOPIC    "tele/safety_audio_1/CLASSIFICATION"
#define MQTT_DEBUG    "tele/safety_audio_1/FEATURES"
#define MQTT_CLIENT   "esp32_audio_1"

// ── I2S / INMP441 ──────────────────────────────────────────────────────────
#define I2S_WS   15
#define I2S_SD   32
#define I2S_SCK  14
#define I2S_PORT I2S_NUM_0

// ── Audio window ───────────────────────────────────────────────────────────
#define SAMPLE_RATE      16000
#define WINDOW_SECONDS   2
#define WINDOW_SAMPLES   (SAMPLE_RATE * WINDOW_SECONDS)  // 32000

// ── STFT parameters (time-scaled from notebook's 44100 Hz values) ──────────
// Notebook: frame=1024, step=512 @ 44100 Hz  →  23.2 ms frame, 11.6 ms hop
// ESP32:    frame=371,  step=186 @ 16000 Hz  →  same durations
// FFT size: nearest power-of-2 ≥ 371 = 512
#define FRAME_LEN    371
#define FRAME_STEP   186
#define OVERLAP_LEN  (FRAME_LEN - FRAME_STEP)   // 185 — overlap kept between frames
#define FFT_SIZE     512
#define FFT_BINS     (FFT_SIZE / 2 + 1)          // 257

// ── Mel filter bank ────────────────────────────────────────────────────────
#define NUM_MEL   64
#define MEL_LO    80.0f
#define MEL_HI    8000.0f   // Nyquist for 16 kHz (notebook uses 16000 for 44.1 kHz)

// ── Model geometry ─────────────────────────────────────────────────────────
// v13: 2×2 MaxPool applied here in firmware before feeding model.
// Input frames: 170 (even) → 85 pooled time frames; 64 mel bins → 32 pooled bins.
#define NUM_INPUT_FRAMES  170
#define NUM_INPUT_MEL     64
#define NUM_POOL_FRAMES   85    // NUM_INPUT_FRAMES / 2
#define NUM_POOL_MEL      32    // NUM_INPUT_MEL / 2
#define MODEL_IN    (NUM_POOL_FRAMES * NUM_POOL_MEL)   // 2720
#define NUM_LABELS  12
#define ARENA_KB    115

// ── Labels — v8 TARGET_LABELS order (cell 8 of sound_classification_v8.ipynb)
const char* LABELS[NUM_LABELS] = {
  "glass_breaking",
  "gunshot",
  "explosion_or_fireworks",
  "impact_or_thud",
  "scream_or_shout",
  "siren_or_alarm",
  "footsteps",
  "crying_or_sobbing",
  "pet_noise",
  "weather_noise",
  "mechanical_noise",
  "unknown_background"
};


// ── Globals ───────────────────────────────────────────────────────────────
// Streaming audio approach: instead of a 64 KB audioBuf for the full 2 s window,
// we keep a FRAME_LEN-sample sliding window and process each frame on the fly.
// Total samples read = FRAME_LEN + (NUM_FRAMES-1)*FRAME_STEP = 31991 ≈ same as before.
// audioBuf is gone; streamBuf is 371*2 = 742 bytes in BSS.
static int16_t   streamBuf[FRAME_LEN];   // sliding window: 742 bytes
static int32_t   tmpReadBuf[256];        // I2S DMA intermediary: 1 KB
static uint8_t*  tensorArena = nullptr;  // heap: ARENA_KB * 1024

float  frame[FFT_SIZE];          // 2 KB
float  fftRe[FFT_SIZE];          // 2 KB
float  fftIm[FFT_SIZE];          // 2 KB
float  hannWindow[FRAME_LEN];    // 1.5 KB
float  melPoints[NUM_INPUT_MEL + 2];  // mel triangle Hz endpoints: 264 bytes
float  binFreqs[FFT_BINS];            // FFT bin Hz values: 1 KB
float  prevMelLine[NUM_INPUT_MEL];    // previous mel frame for time-axis pooling: 256 bytes
int8_t modelInput[MODEL_IN];          // 2.7 KB — pooled normalized quantized, int8 I/O for v14

WiFiClient   wifiClient;
PubSubClient mqtt(wifiClient);

static tflite::MicroErrorReporter microErrorReporter;
static tflite::AllOpsResolver     resolver;
static tflite::MicroInterpreter*  interpreter  = nullptr;
static TfLiteTensor*              inputTensor  = nullptr;
static TfLiteTensor*              outputTensor = nullptr;

// ── Mel helpers ────────────────────────────────────────────────────────────
static float hzToMel(float hz) { return 2595.0f * log10f(1.0f + hz / 700.0f); }
static float melToHz(float mel) { return 700.0f * (powf(10.0f, mel / 2595.0f) - 1.0f); }

void buildMelFilterBank() {
  float melLo = hzToMel(MEL_LO);
  float melHi = hzToMel(MEL_HI);
  for (int i = 0; i < NUM_INPUT_MEL + 2; i++)
    melPoints[i] = melToHz(melLo + i * (melHi - melLo) / (NUM_INPUT_MEL + 1));
  for (int k = 0; k < FFT_BINS; k++)
    binFreqs[k] = (float)k * SAMPLE_RATE / FFT_SIZE;
}

// ── Hann window (computed once) ────────────────────────────────────────────
void buildHannWindow() {
  for (int i = 0; i < FRAME_LEN; i++)
    hannWindow[i] = 0.5f * (1.0f - cosf(2.0f * M_PI * i / (FRAME_LEN - 1)));
}

// ── Bit-reversal permutation for in-place FFT ─────────────────────────────
static void fftBitReverse(float* re, float* im, int n) {
  int j = 0;
  for (int i = 1; i < n; i++) {
    int bit = n >> 1;
    for (; j & bit; bit >>= 1) j ^= bit;
    j ^= bit;
    if (i < j) { float t = re[i]; re[i] = re[j]; re[j] = t;
                  t = im[i]; im[i] = im[j]; im[j] = t; }
  }
}

// ── Cooley-Tukey radix-2 FFT ──────────────────────────────────────────────
void computeFFT(const float* x) {
  for (int i = 0; i < FFT_SIZE; i++) { fftRe[i] = (i < FRAME_LEN) ? x[i] : 0.0f; fftIm[i] = 0.0f; }
  fftBitReverse(fftRe, fftIm, FFT_SIZE);
  for (int len = 2; len <= FFT_SIZE; len <<= 1) {
    float ang = -2.0f * M_PI / len;
    float wRe = cosf(ang), wIm = sinf(ang);
    for (int i = 0; i < FFT_SIZE; i += len) {
      float curRe = 1.0f, curIm = 0.0f;
      for (int j = 0; j < len / 2; j++) {
        float uRe = fftRe[i+j], uIm = fftIm[i+j];
        float vRe = fftRe[i+j+len/2]*curRe - fftIm[i+j+len/2]*curIm;
        float vIm = fftRe[i+j+len/2]*curIm + fftIm[i+j+len/2]*curRe;
        fftRe[i+j] = uRe+vRe; fftIm[i+j] = uIm+vIm;
        fftRe[i+j+len/2] = uRe-vRe; fftIm[i+j+len/2] = uIm-vIm;
        float tmp = curRe*wRe - curIm*wIm;
        curIm = curRe*wIm + curIm*wRe; curRe = tmp;
      }
    }
  }
}

// ── Helper: fill streamBuf[pos..pos+count-1] from I2S ─────────────────────
static void i2sFill(int16_t* buf, int pos, int count) {
  while (count > 0) {
    int chunk = min(count, 256);
    size_t got = 0;
    i2s_read(I2S_PORT, tmpReadBuf, chunk * sizeof(int32_t), &got, portMAX_DELAY);
    int n = got / sizeof(int32_t);
    for (int i = 0; i < n; i++)
      buf[pos + i] = (int16_t)(tmpReadBuf[i] >> 16);
    pos   += n;
    count -= n;
  }
}

// ── Process one mel frame from streamBuf → modelInput[f*NUM_MEL ..] ────────
// Compute 64 log-mel bin values from streamBuf into melOut[NUM_INPUT_MEL].
static void computeMelFrame(float* melOut) {
  for (int i = 0; i < FRAME_LEN; i++)
    frame[i] = streamBuf[i] / 8192.0f * hannWindow[i];
  computeFFT(frame);
  for (int m = 0; m < NUM_INPUT_MEL; m++) {
    float lo  = melPoints[m];
    float ctr = melPoints[m + 1];
    float hi  = melPoints[m + 2];
    float invAsc  = (ctr > lo) ? 1.0f / (ctr - lo)  : 0.0f;
    float invDesc = (hi > ctr)  ? 1.0f / (hi  - ctr) : 0.0f;
    float energy  = 0.0f;
    for (int k = 0; k < FFT_BINS; k++) {
      float f_hz = binFreqs[k];
      float w = 0.0f;
      if      (f_hz >= lo  && f_hz <= ctr) w = (f_hz - lo)  * invAsc;
      else if (f_hz >  ctr && f_hz <= hi)  w = (hi  - f_hz) * invDesc;
      energy += (fftRe[k]*fftRe[k] + fftIm[k]*fftIm[k]) * w;
    }
    melOut[m] = logf(energy + 1e-6f);
  }
}

// Capture 170 frames, apply 2x2 MaxPool on the fly, write 85x32 floats to modelInput.
// Even frames are buffered in prevMelLine; odd frames are pooled with the previous one
// (time axis), then adjacent mel bin pairs are max-pooled (freq axis).
float captureAndProcess() {
  float curMel[NUM_INPUT_MEL];

  i2sFill(streamBuf, 0, FRAME_LEN);

  int64_t sumSq = 0;
  for (int i = 0; i < FRAME_LEN; i++) sumSq += (int64_t)streamBuf[i] * streamBuf[i];
  float rms = sqrtf((float)sumSq / FRAME_LEN);

  for (int f = 0; f < NUM_INPUT_FRAMES; f++) {
    computeMelFrame(curMel);

    if (f % 2 == 0) {
      memcpy(prevMelLine, curMel, NUM_INPUT_MEL * sizeof(float));
    } else {
      int outF = f / 2;
      for (int m = 0; m < NUM_INPUT_MEL; m += 2) {
        float t0 = fmaxf(prevMelLine[m],   curMel[m]);
        float t1 = fmaxf(prevMelLine[m+1], curMel[m+1]);
        float pooled = fmaxf(t0, t1);
        float norm = (pooled - NORM_MEAN) / NORM_STD;
        int q = (int)roundf(norm / INPUT_SCALE + INPUT_ZERO_POINT);
        modelInput[outF * NUM_POOL_MEL + m / 2] = (int8_t)(q < -128 ? -128 : q > 127 ? 127 : q);
      }
    }

    if (f < NUM_INPUT_FRAMES - 1) {
      memmove(streamBuf, streamBuf + FRAME_STEP, OVERLAP_LEN * sizeof(int16_t));
      i2sFill(streamBuf, OVERLAP_LEN, FRAME_STEP);
    }
  }
  return rms;
}

// ── I2S / Wi-Fi / MQTT ─────────────────────────────────────────────────────
void setupI2S() {
  i2s_config_t cfg = {
    .mode                = (i2s_mode_t)(I2S_MODE_MASTER | I2S_MODE_RX),
    .sample_rate         = SAMPLE_RATE,
    .bits_per_sample     = I2S_BITS_PER_SAMPLE_32BIT,
    .channel_format      = I2S_CHANNEL_FMT_ONLY_LEFT,
    .communication_format= I2S_COMM_FORMAT_STAND_I2S,
    .intr_alloc_flags    = ESP_INTR_FLAG_LEVEL1,
    .dma_buf_count       = 4,
    .dma_buf_len         = 256,
    .use_apll            = false,
    .tx_desc_auto_clear  = false,
    .fixed_mclk          = 0
  };
  i2s_pin_config_t pins = {
    .bck_io_num   = I2S_SCK, .ws_io_num = I2S_WS,
    .data_out_num = I2S_PIN_NO_CHANGE, .data_in_num = I2S_SD
  };
  i2s_driver_install(I2S_PORT, &cfg, 0, NULL);
  i2s_set_pin(I2S_PORT, &pins);
  i2s_zero_dma_buffer(I2S_PORT);
}

void connectWifi() {
  Serial.printf("Connecting to %s", WIFI_SSID);
  WiFi.begin(WIFI_SSID, WIFI_PASSWORD);
  while (WiFi.status() != WL_CONNECTED) { delay(500); Serial.print("."); }
  Serial.printf("\nIP: %s\n", WiFi.localIP().toString().c_str());
}

void connectMqtt() {
  mqtt.setServer(MQTT_HOST, MQTT_PORT);
  while (!mqtt.connected()) {
    Serial.print("Connecting MQTT...");
    if (mqtt.connect(MQTT_CLIENT)) Serial.println(" ok");
    else { Serial.printf(" failed (%d), retry 3s\n", mqtt.state()); delay(3000); }
  }
}

// ── Setup ──────────────────────────────────────────────────────────────────
void setup() {
  Serial.begin(115200);
  delay(1000);

  buildHannWindow();
  buildMelFilterBank();

  // Allocate before Wi-Fi to get the largest contiguous block (measured max: ~110 KB).
  // Static BSS is not viable: TFLite Micro library leaves only ~17 KB of headroom in dram0_0_seg.
  tensorArena = (uint8_t*)malloc(ARENA_KB * 1024);
  if (!tensorArena) {
    Serial.printf("FATAL: malloc tensorArena failed (%d KB) — free: %u, max: %u\n",
                  ARENA_KB, ESP.getFreeHeap(), ESP.getMaxAllocHeap());
    while (true) delay(1000);
  }
  Serial.printf("Free heap after arena malloc: %u bytes\n", ESP.getFreeHeap());

  setupI2S();
  connectWifi();
  connectMqtt();

  const tflite::Model* model = tflite::GetModel(distilled_student_int8);
  if (model->version() != TFLITE_SCHEMA_VERSION) {
    Serial.printf("Model schema mismatch: %lu vs %d\n", model->version(), TFLITE_SCHEMA_VERSION);
    while (true) delay(1000);
  }
  static tflite::MicroInterpreter staticInterpreter(
      model, resolver, tensorArena, ARENA_KB * 1024, &microErrorReporter);
  interpreter = &staticInterpreter;
  if (interpreter->AllocateTensors() != kTfLiteOk) {
    Serial.printf("AllocateTensors failed (%d KB arena) — increase ARENA_KB\n", ARENA_KB);
    while (true) delay(1000);
  }
  Serial.printf("Arena used: %u / %u bytes\n",
                interpreter->arena_used_bytes(), (unsigned)(ARENA_KB * 1024));
  inputTensor  = interpreter->input(0);
  outputTensor = interpreter->output(0);
  Serial.println("TFLite model loaded");
  Serial.println("ESP32 TinyML audio node ready");
}

// ── Loop ───────────────────────────────────────────────────────────────────
void loop() {
  if (!mqtt.connected()) connectMqtt();
  mqtt.loop();

  unsigned long t0 = millis();

  // 1. Capture 2 s of audio and compute mel spectrogram in one streaming pass
  float rms = captureAndProcess();

  // 2. Inference
  memcpy(inputTensor->data.int8, modelInput, MODEL_IN * sizeof(int8_t));
  interpreter->Invoke();

  unsigned long inferenceMs = millis() - t0;

  // 3. Decode best label (float32 logits — v13 model)
  int bestIdx = 0;
  for (int i = 1; i < NUM_LABELS; i++)
    if (outputTensor->data.f[i] > outputTensor->data.f[bestIdx]) bestIdx = i;

  float expSum = 0.0f;
  for (int i = 0; i < NUM_LABELS; i++) expSum += expf(outputTensor->data.f[i]);
  float confidence = expf(outputTensor->data.f[bestIdx]) / expSum;

  // 4. Publish classification
  char payload[200];
  snprintf(payload, sizeof(payload),
    "{\"label\":\"%s\",\"confidence\":%.2f,\"rms\":%.1f,\"inference_ms\":%lu,\"model\":\"distilled_student_v15\"}",
    LABELS[bestIdx], confidence, rms, inferenceMs);
  mqtt.publish(MQTT_TOPIC, payload);

  Serial.printf("label=%s conf=%.2f rms=%.1f inf=%lums\n",
                LABELS[bestIdx], confidence, rms, inferenceMs);
}
