loonaarc/conf/(commit log)

2026-05-14 Add new images and sitemap configuration for Lab 3
    - Added image-4.png to the repository.
    - Added image.png, which is too large to display in the diff.
    - Created a new sitemap file lab3.sitemap with configuration for device and control frames, including switches for Relay and Motion automation.
2026-05-14 Add MQTT Explorer switch result image to documentation
2026-05-15 Add PowerShell script to start safety monitoring tools
    - Created start_safety_monitor.ps1 to automate the launch of Tasmota web UI, Mosquitto MQTT broker, MQTT Explorer, and openHAB with Basic UI sitemap.
    - Implemented a function to check for the existence of executables before starting them.
    - Included appropriate wait times and user feedback for a smoother startup experience.
2026-05-15 Update architecture and documentation for ESP #2: add PWM-controlled buzzer and adjust relay configuration
2026-05-21 Add safety context sensors: Vibration, Sound Level, and Touch
2026-05-21 Update architecture documentation and PowerShell script to include specific Tasmota web UI URLs for ESP devices
2026-05-21 Update icons for sensor items and enhance control frame layout in safety monitor sitemap
2026-05-22 Add GeoSphere Austria HTTP warning feed integration
    - Introduced `http.things` to define the GeoSphere Austria HTTP warning feed.
    - Updated `README.md` to include details about the new HTTP thing and its usage.
    - Added new items in `safety_monitor.items` for displaying warning information.
    - Modified `addons.cfg` to include the HTTP binding.
    - Enhanced `safety_monitor.sitemap` to show external safety context with warning details.
    - Updated the automation rules to react to safety events based on the HTTP feed.
    - Added an image file for visual reference.
    [addons.cfg]
2026-05-22 Add network plan diagram for distributed edge-based safety monitoring system
    - Created a new PlantUML file to visualize the network architecture.
    - Included components such as MQTT broker, openHAB, and various ESP safety devices.
    - Defined interactions between devices and services, including MQTT telemetry and HTTP bindings.
    - Documented rule logic for safety monitoring and alarm activation.
2026-06-04 Add project documentation for safety monitoring system and TinyML extension
    - Created model comparison document to outline differences between regular TensorFlow and TinyML models.
    - Added security notes detailing current setup, risks, and planned improvements.
    - Developed final project checklist to track requirements and progress.
    - Drafted final demo flow script for live demonstration of the system.
    - Compiled mid-term project checklist to assess current status and next actions.
    - Established project evidence document to collect screenshots and photos of the system.
    - Introduced project plan outlining strategy, device roles, and milestones for the safety monitoring system.
    - Set up TinyML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
2026-06-04 Add SQLite persistence configuration for safety monitoring system
    - Introduced a new image file for persistence proof.
    - Created a persistence configuration file (jdbc.persist) defining strategies for various items in the safety monitoring system.
    - Added a JDBC configuration file (jdbc.cfg) specifying the SQLite database URL for persistence.
    [addons.cfg, jdbc.cfg, runtime.cfg]
2026-06-05 Add openHAB Cloud Connector configuration file and remote UI screenshot
    - Created a new configuration file `openhabcloud.cfg` for the openHAB Cloud Connector with options for base URL, mode, and item exposure.
    - Added a screenshot `27-myopenhab-remote-basic-ui.png` to the documentation for visual reference of the remote basic UI.
    [addons.cfg, openhabcloud.cfg]
2026-06-13 Add ESP32 audio node implementation with I2S microphone and MQTT integration
    - Created README.md for project overview and hardware setup instructions.
    - Added Arduino sketches for I2S microphone debugging and audio feature extraction.
    - Implemented MQTT features for audio classification and feature publishing.
    - Developed TinyML inference sketch for sound classification using a pre-trained model.
    - Included model_data.h as a placeholder for the TFLite model.
    - Established project structure for Arduino and PlatformIO environments.
2026-06-14 Refactor sound classification notebook: streamline dataset extraction, improve progress reporting, and enhance error handling for ESC-50 download.
2026-06-18 Refactor sound classification notebook: improve dataset extraction, checkpoint handling, and model evaluation
    - Updated dataset extraction to include a filter for 'data' during extraction.
    - Simplified checkpoint callback logic and added model saving after training.
    - Enhanced TFLite model evaluation to support LiteRT interpreter.
    - Improved warnings handling for quantization statistics.
    - Refined YAMNet fine-tuning process and added checks for trainable variables.
    - Cleaned up code formatting and comments for better readability.
2026-06-18 Update sound classification notebook and add model comparison document
    - Added FEATURE_CACHE_VERSION and STUDENT_VERSION constants to the sound classification notebook for better version control.
    - Removed redundant cache version strings from the audio loading section.
    - Fixed print statement formatting in the sound classification notebook.
    - Introduced a new PDF document for model comparison to aid in evaluating different approaches.
2026-06-20 Refactor sound classification model to use Functional API for better tensor access; update BatchNormalization calibration for improved accuracy and model size optimization.
